LokiMetaSmith/polyvent_control_module/Boards CAD/esp32_main_card/firmware/readme.txt

VentOS runs on this card during normal operation, however scripts in the test_scripts folder can also be used. 

This is the link to the VentOS gitlab repo: https://gitlab.com/project-ventos/ventos
