LokiMetaSmith/polyvent_control_module/Education proportional valve configuration/BOM/Control module parts list.xlsx

Module name in CAD | Multipart assembly name in CAD | Component name in CAD | Description | Quantity | Part number / manufacturing description | Vendor | Notes
Control module |  |  |  |  | Control module wiki link (https://gitlab.com/polyvent/polyvent_control_module/-/wikis/1.0-system-overview)
 |  | guide box | Guide and holds in place the PCB's | 1 | Manufactured out of PLA on a 3D printer
 |  | guide box base | Holds the backp,lane and mounts the guide box to the base frame | 1 | Manufactured out of PLA on a 3D printer
 |  | M3 self-tappping screw 90380A352 | M3*12mm self-tapping screws. These connect the two guide box parts, constrain the cards and hold the backplane | 32 | 90380A352 (https://www.mcmaster.com/90380A352) | McMaster-Carr
 |  | M4*10mm screw 92095A190 | M4*10mm bolts, these bolt the guide box to the faceplate | 6 | 92095A190 (https://www.mcmaster.com/92095A190) | McMaster-Carr
 |  | power plug BVA01-Z0000-01 | Power plug with fuse and switch | 1 | BVA01-Z0000-01 | Digikey | will also need to source a fuse for it
 |  | M3 * 14mm 92095A168 | M3 * 14mm rounded head bolt | 2 | 92095A168 (https://www.mcmaster.com/92095A168) | McMaster-Carr | Generic part
 |  | Not included in CAD | 14AWG wire (black and red) | <1m | Generic | Amazon
 |  | Not included in CAD | 22AWG wire (multicolored) | 5-10m | Generic | Amazon
 |  | Not included in CAD | Not included in CAD | 5 | large spade connector (blue) (https://www.amazon.ca/AIRIC-100pcs-Insulated-Disconnect-Terminal/dp/B06XCWHY1B) | Baomain, on Amazon | These get used up a lot since they're used improperly often. It's good to have way more then you need
 |  | Not included in CAD | Fork connectors (thin wire) | 10 to 20 | small crimp fork (red) (https://www.amazon.ca/Baomain-Insulated-Connector-Electrical-Terminal/dp/B01B1753K2) | Baomain, on Amazon | These get used up a lot since they're used improperly often. It's good to have way more then you need
 |  | Not included in CAD | Fork connectors (thick wire) | 15 to 25 | large crimp fork (blue) (https://www.amazon.ca/gp/product/B01B1DL4OA/ref=ppx_yo_dt_b_search_asin_title?ie=UTF8&psc=1) | Baomain, on Amazon | These get used up a lot since they're used improperly often. It's good to have way more then you need
 |  | Not included in CAD | Crimp ferrules | 1 | Crimp ferrule kit (https://www.amazon.ca/Self-Adjustable-Assortment-Insulated-Electrical-Connectors/dp/B08G4KJ2RR) | Amazon | These get used up a lot since they're used improperly often. It's good to have way more then you need
 | sensing card
 |  | M3 Locknut 90576A102 | M3 locknut | 2 | 90576A102 (https://www.mcmaster.com/90576A102) | McMaster-Carr | Generic part, these should be pre-threaded before insertion, they will destroy your faceplate during threading if you don't do this
 |  | M3*14mm 92095A168 | M3 * 14mm rounded head bolt | 2 | 92095A168 (https://www.mcmaster.com/92095A168) | McMaster-Carr | Generic part
 |  | sensing card face plate |  | 1 | Manufactured out of PLA on a 3D printer
 |  | Sensing card BOM | List of electrical components needed to build the sensing card, it is auto-generated by eagle so it isn't included here | 1 | Many part numbers combined, link to the BOM | Digikey, Mouser
 |  | Sensing card PCB | Sensing card circuit board, can be made by any PCB house | 1 | Link to the design files | JLCPCB
 |  | 15mm brass tube 8859K18 | Thin brass tube, cut to 14mm long | 4 * 14mm: 64mm total | 8859K18 (https://www.mcmaster.com/8859K18) | McMaster-Carr
 | ESP32 card
 |  | M3 Locknut 90576A102 | M3 locknut | 2 | 90576A102 (https://www.mcmaster.com/90576A102) | McMaster-Carr | Generic part, these should be pre-threaded before insertion, they will destroy your faceplate during threading if you don't do this
 |  | M3*14mm 92095A168 | M3 * 14mm rounded head bolt | 2 | 92095A168 (https://www.mcmaster.com/92095A168) | McMaster-Carr | Generic part
 |  | main card face plate |  | 1 | Manufactured out of PLA on a 3D printer
 |  | Main card BOM | List of electrical components needed to build the main card, it is auto-generated by eagle so it isn't included here | 1 | Many part numbers combined, link to the BOM | Digikey, Mouser
 |  | Main card PCB | Main card circuit board, can be made by any PCB house | 1 | Link to the design files | JLCPCB
 | Valves card
 |  | M3 Locknut 90576A102 | M3 locknut | 2 | 90576A102 (https://www.mcmaster.com/90576A102) | McMaster-Carr | Generic part, these should be pre-threaded before insertion, they will destroy your faceplate during threading if you don't do this
 |  | M3*14mm 92095A168 | M3 * 14mm rounded head bolt | 2 | 92095A168 (https://www.mcmaster.com/92095A168) | McMaster-Carr | Generic part
 |  | valves card faceplate |  | 1 | Manufactured out of PLA on a 3D printer
 |  | Valves card BOM | List of electrical components needed to build the valves card, it is auto-generated by eagle so it isn't included here | 1 | Many part numbers combined, link to the BOM | Digikey, Mouser
 |  | Valves card PCB | Valves card circuit board, can be made by any PCB house | 1 | Link to the design files | JLCPCB
 | Backplane V1.2
 |  | Backplane BOM | List of electrical components needed to build the Backplane, it is auto-generated by eagle so it isn't included here | 1 | Many part numbers combined, link to the BOM | Digikey, Mouser
 |  | Backplane PCB | Backplane circuit board, can be made by any PCB house | 1 | Link to the design files | JLCPCB
 | Prototype card (optional)
 |  | M3 Locknut 90576A102 | M3 locknut | 2 | 90576A102 (https://www.mcmaster.com/90576A102) | McMaster-Carr
 |  | M3*14mm 92095A168 | M3 * 14mm rounded head bolt | 2 | 92095A168 (https://www.mcmaster.com/92095A168) | McMaster-Carr
 |  | prototype card faceplate |  | 1 | Custom made by you! (if you choose to build one)
 |  | prototype card BOM |  | 1 | Custom made by you! (if you choose to build one)
 |  | Prototype card PCB | Prototype card circuit board, can be made by any PCB house | 1 | Link to the design files | JLCPCB
 | PSU enclosure
 |  | psu cover 3d printed | Covers the mains wiring and makes everything look neat | 1 | Manufactured out of PLA on a 3d printer, no part number
 |  | PSU cover base plate | Connects the PSU's and psu cover the the base of the machine, acts as a heatsink for the PSU's | 1 | Milled out of aluminum
 |  | LRS-150-24 | 24V power supply | 1 | LRS-150 | Digikey, Mouser, MeanWell
 |  | RS-25-5 | 5V power supply | 1 | RS-25-5 | Digikey, Mouser, MeanWell
 |  | RS-25-3.3 | 3.3V power supply | 1 | RS-25-3.3 | Digikey, Mouser, MeanWell
 |  | M3*6mm 92095A179 | M3 * 6mm bolt | 6 | 92095A179 (https://www.mcmaster.com/92095A179) | McMaster-Carr
