LokiMetaSmith/polyvent_control_module/Boards CAD/blank_card/CAD_model/blank_faceplate_v8.step

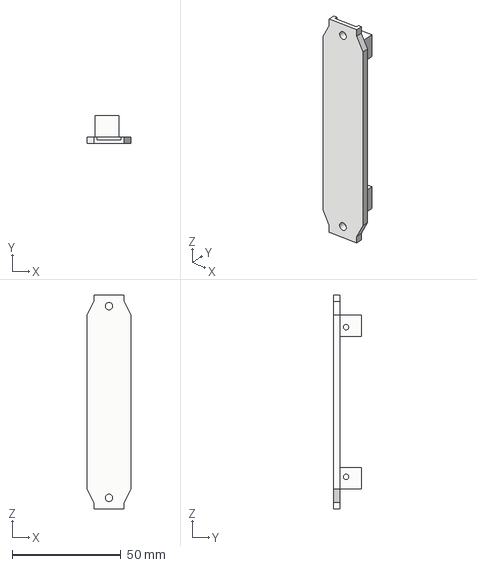
[picture p1: CAD file, 2022-01-12]
Boards CAD/blank_card/CAD_model/blank_faceplate_v8.step
20.2 x 13.0 x 98.3 mm
bent 3d printed body
