LokiMetaSmith/polyvent_control_module/Boards CAD/esp32_main_card/CAD_model/ESP32 card V2.2 v1.step

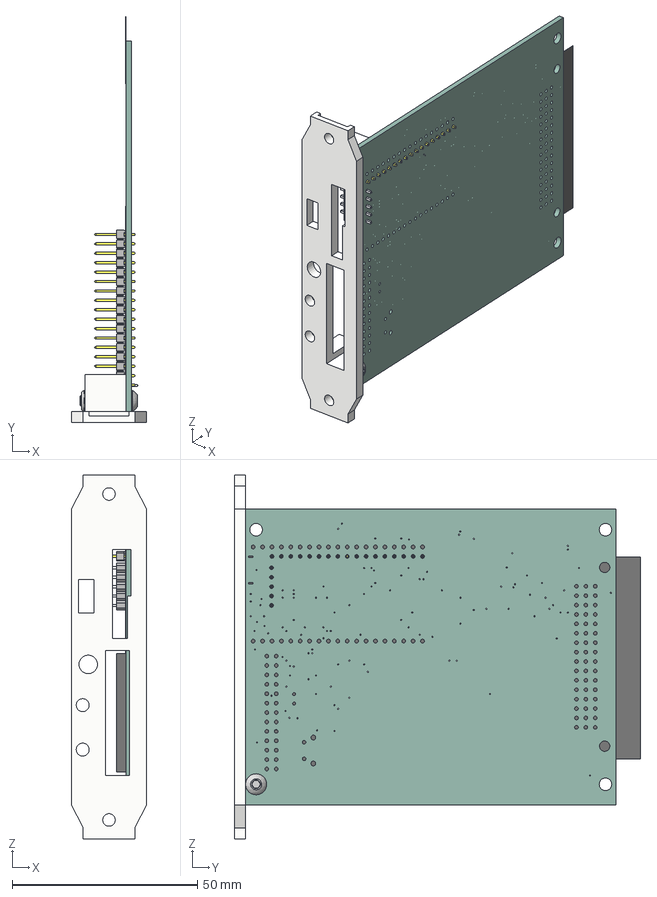
[picture p2: CAD file, 2022-10-12]
Boards CAD/esp32_main_card/CAD_model/ESP32 card V2.2 v1.step
20.2 x 109.6 x 98.3 mm
Board (1)
CL-SB-23A-11T
MODULE_ESP32-DEVKITC-32D
FSMRA4JH04
GCT_USB3090-XX-X_REVE
FE13-2W
HARTING_09231486921 (1)
LED3MM
1X05
_TSW-117-07-G-S_body
_T-1S6-07-TSW-1-07-17-S
valves card face plate (1)
M3*14mm 92095A168
M3 Locknut 90576A102
