LokiMetaSmith/polyvent_control_module/Boards CAD/sensor_card/CAD_model/Sensing card V2.2 v1.step

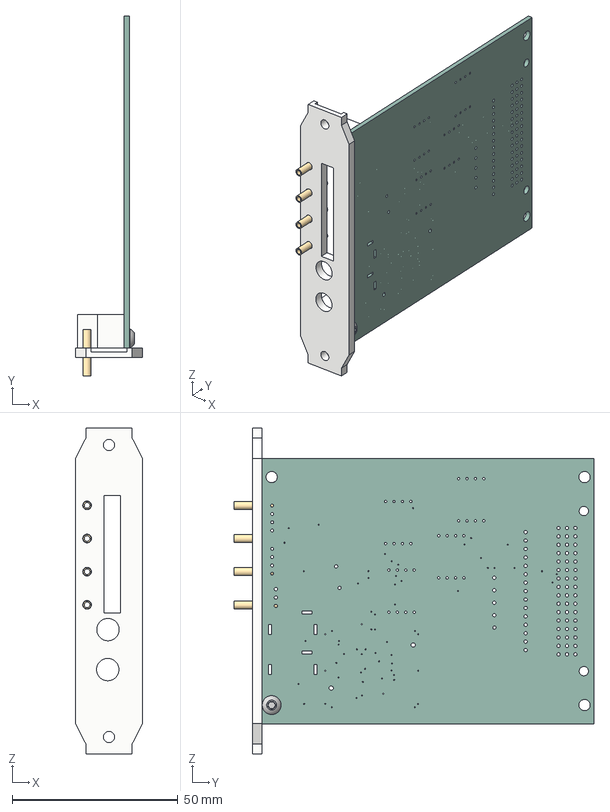
[picture p3: CAD file, 2022-10-12]
Boards CAD/sensor_card/CAD_model/Sensing card V2.2 v1.step
20.2 x 108.5 x 98.3 mm
Board (3)
sensor card faceplate
15mm brass tube 8859K18 x 4
M3*14mm 92095A168
M3 Locknut 90576A102
