LokiMetaSmith/polyvent_control_module/Boards CAD/valves_card/CAD_model/Valves card V2.1 v1.step

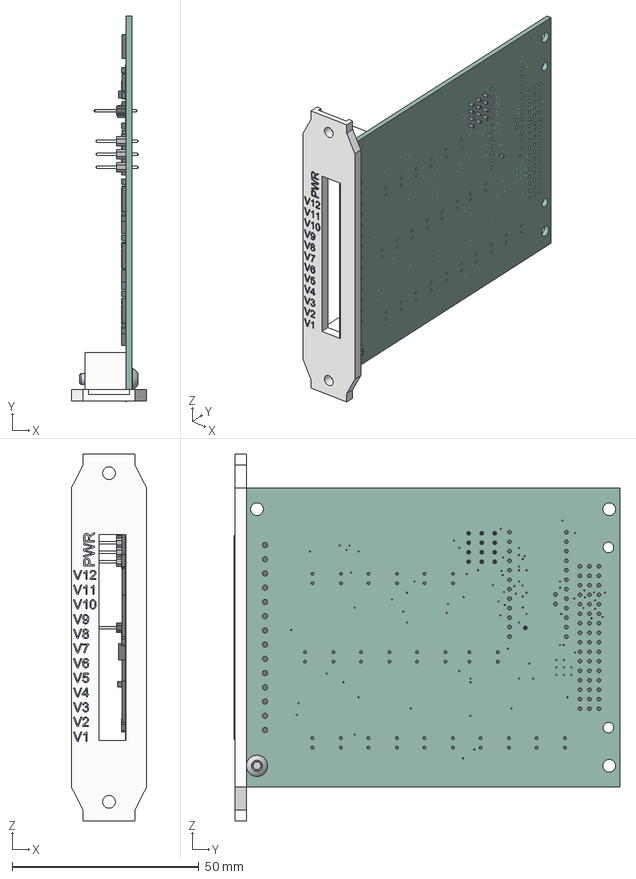
[picture p4: CAD file, 2022-10-12]
Boards CAD/valves_card/CAD_model/Valves card V2.1 v1.step
20.2 x 103.3 x 98.3 mm
Board (2)
DIP762W25P254L650H453Q4B x 12
SOT230P700X180-4N
R0805 x 36
DPAK_TO252 x 12
SJ_2S-NO
SJ_2S-TRACE (1)
JP1_SPARKFUN-SAMD21-MINI-BREAKOUT-V10 (1)
CUI_TBP02R1-381-14BE
HARTING_09231486921 (2)
C0805
C1206
1X01 (1)
1X04 (1) x 3
bent 3d printed body
M3 Locknut 90576A102
M3*14mm 92095A168
