LokiMetaSmith/polyvent_control_module/(list of files, cad)

Other CAD files:
Boards CAD/blank_card/CAD_model/blank_faceplate.f3d
Boards CAD/esp32_main_card/CAD_model/ESP32 card V2.2 v1.f3d
Boards CAD/sensor_card/CAD_model/Sensing card V2.2 v1.f3d
Boards CAD/valves_card/CAD_model/Valves card V2.1 v1.f3d
Education proportional valve configuration/CAD/Education configuration case.f3d
