LokiMetaSmith/polyvent_control_module/Boards CAD/motor_control_card/board/motor control board.brd

## EAGLE design Boards CAD/motor_control_card/board/motor control board.brd (2022-01-12)

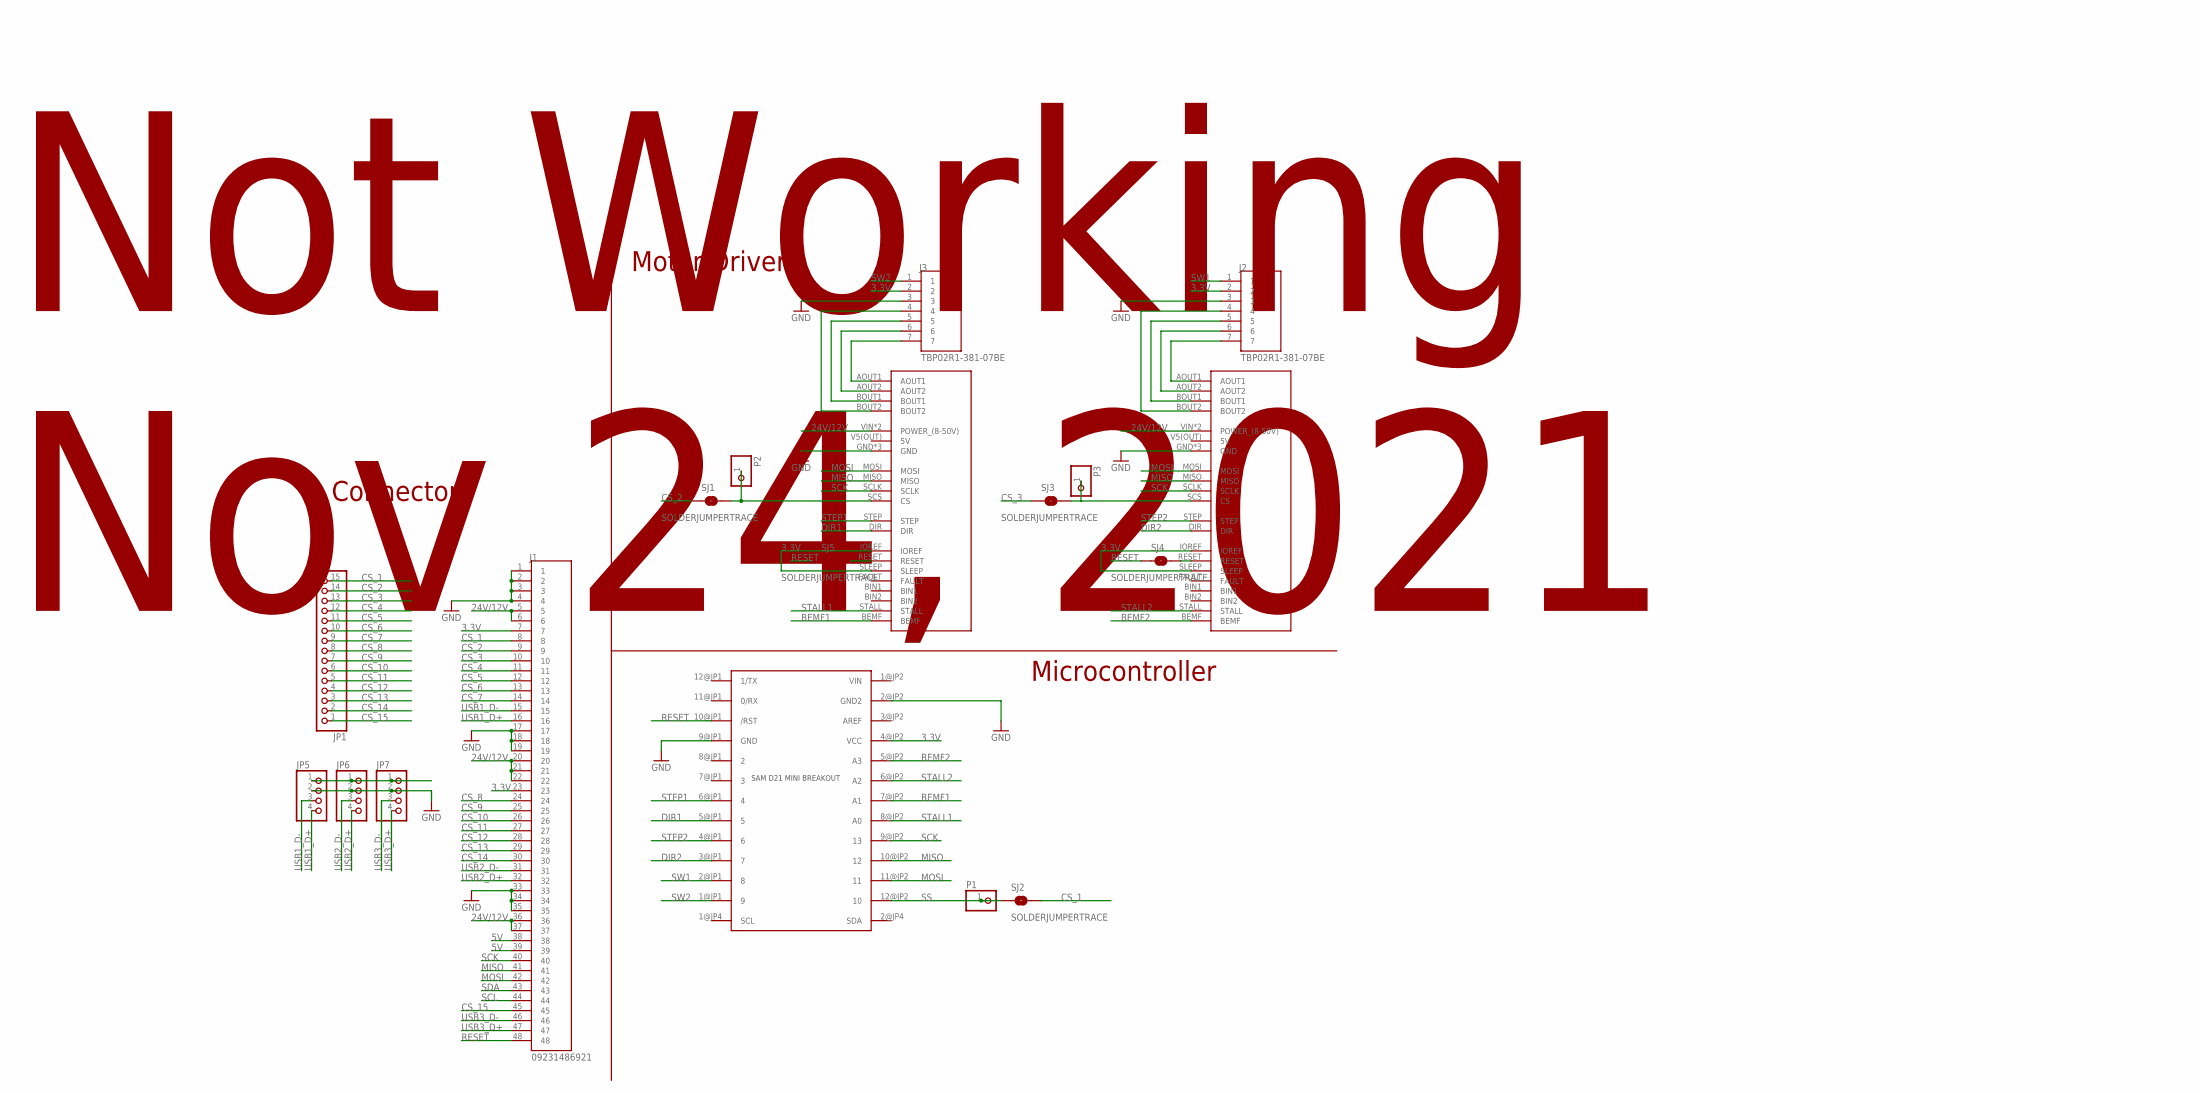
[picture p5: schematic motor control board.sch]

Parts:
J1: 09231486921; HARTING_09231486921
J2, J3: TBP02R1-381-07BE; CUI_TBP02R1-381-07BE
JP1: PINHD-1X15; 1X15
JP5, JP6, JP7: PINHD-1X4; 1X04
P1, P2, P3: PINHD-1X1; 1X01
SJ1, SJ2, SJ3, SJ4, SJ5: SOLDERJUMPERTRACE; SJ_2S-TRACE
U$1, U$2: POLOLU_HIGH-POWER_STEPPER_MOTOR_DRIVER_36V4; BREAKOUT_BOARD
U$4: SAM_D21_MINI_BREAKOUT; JP1_SPARKFUN-SAMD21-MINI-BREAKOUT-V10

Connections:
3.3V: J1.7, J1.23, J2.2, J3.2, U$1.IOREF, U$1.SLEEP, U$2.IOREF, U$2.SLEEP, U$4.4@JP2 (VCC)
5V: J1.38, J1.39, JP5.1, JP6.1, JP7.1
24V/12V: J1.5, J1.6, J1.20, J1.21, J1.22, J1.36, J1.37, U$1.VIN (POWER_(8-50V)), U$1.VIN_2 (POWER_(8-50V)), U$2.VIN (POWER_(8-50V)), U$2.VIN_2 (POWER_(8-50V))
AREF: U$4.3@JP2 (AREF)
BEMF1: U$1.BEMF, U$4.7@JP2 (A1)
BEMF2: U$2.BEMF, U$4.5@JP2 (A3)
CS_1: J1.8, JP1.15, SJ2.2
CS_2: J1.9, JP1.14, SJ1.1
CS_3: J1.10, JP1.13, SJ3.1
CS_4: J1.11, JP1.12
CS_5: J1.12, JP1.11
CS_6: J1.13, JP1.10
CS_7: J1.14, JP1.9
CS_8: J1.24, JP1.8
CS_9: J1.25, JP1.7
CS_10: J1.26, JP1.6
CS_11: J1.27, JP1.5
CS_12: J1.28, JP1.4
CS_13: J1.29, JP1.3
CS_14: J1.30, JP1.2
CS_15: J1.45, JP1.1
DIR1: U$1.DIR, U$4.5@JP1 (5)
DIR2: U$2.DIR, U$4.3@JP1 (7)
GND: J1.1, J1.2, J1.3, J1.4, J1.17, J1.18, J1.19, J1.33, J1.34, J1.35, J2.3, J3.3, JP5.2, JP6.2, JP7.2, U$1.GND, U$1.GND_2 (GND), U$1.GND_3 (GND), U$2.GND, U$2.GND_2 (GND), U$2.GND_3 (GND), U$4.9@JP1 (GND)
MISO: J1.41, U$1.MISO, U$2.MISO, U$4.10@JP2 (12)
MOSI: J1.42, U$1.MOSI, U$2.MOSI, U$4.11@JP2 (11)
unnamed: J3.7, U$1.AOUT1
unnamed: J3.6, U$1.AOUT2
unnamed: J3.5, U$1.BOUT1
unnamed: J3.4, U$1.BOUT2
unnamed: SJ4.2, U$2.RESET
unnamed: J2.7, U$2.AOUT1
unnamed: J2.6, U$2.AOUT2
unnamed: J2.5, U$2.BOUT1
unnamed: J2.4, U$2.BOUT2
unnamed: P2.1, SJ1.2, U$1.SCS (CS)
unnamed: SJ5.2, U$1.RESET
unnamed: P3.1, SJ3.2, U$2.SCS (CS)
RESET: J1.48, SJ4.1, SJ5.1, U$4.10@JP1 (/RST)
SCK: J1.40, U$1.SCLK, U$2.SCLK, U$4.9@JP2 (13)
SCL: J1.44
SDA: J1.43
SS: P1.1, SJ2.1, U$4.12@JP2 (10)
STALL1: U$1.STALL, U$4.8@JP2 (A0)
STALL2: U$2.STALL, U$4.6@JP2 (A2)
STEP1: U$1.STEP, U$4.6@JP1 (4)
STEP2: U$2.STEP, U$4.4@JP1 (6)
SW1: J2.1, U$4.2@JP1 (8)
SW2: J3.1, U$4.1@JP1 (9)
USB1_D+: J1.16, JP5.4
USB1_D-: J1.15, JP5.3
USB2_D+: J1.32, JP6.4
USB2_D-: J1.31, JP6.3
USB3_D+: J1.47, JP7.4
USB3_D-: J1.46, JP7.3
VIN: U$4.1@JP2 (VIN)

Notes on the sheet:
Microcontroller
Motor Drivers
Connectors
Not Working Nov 24, 2021

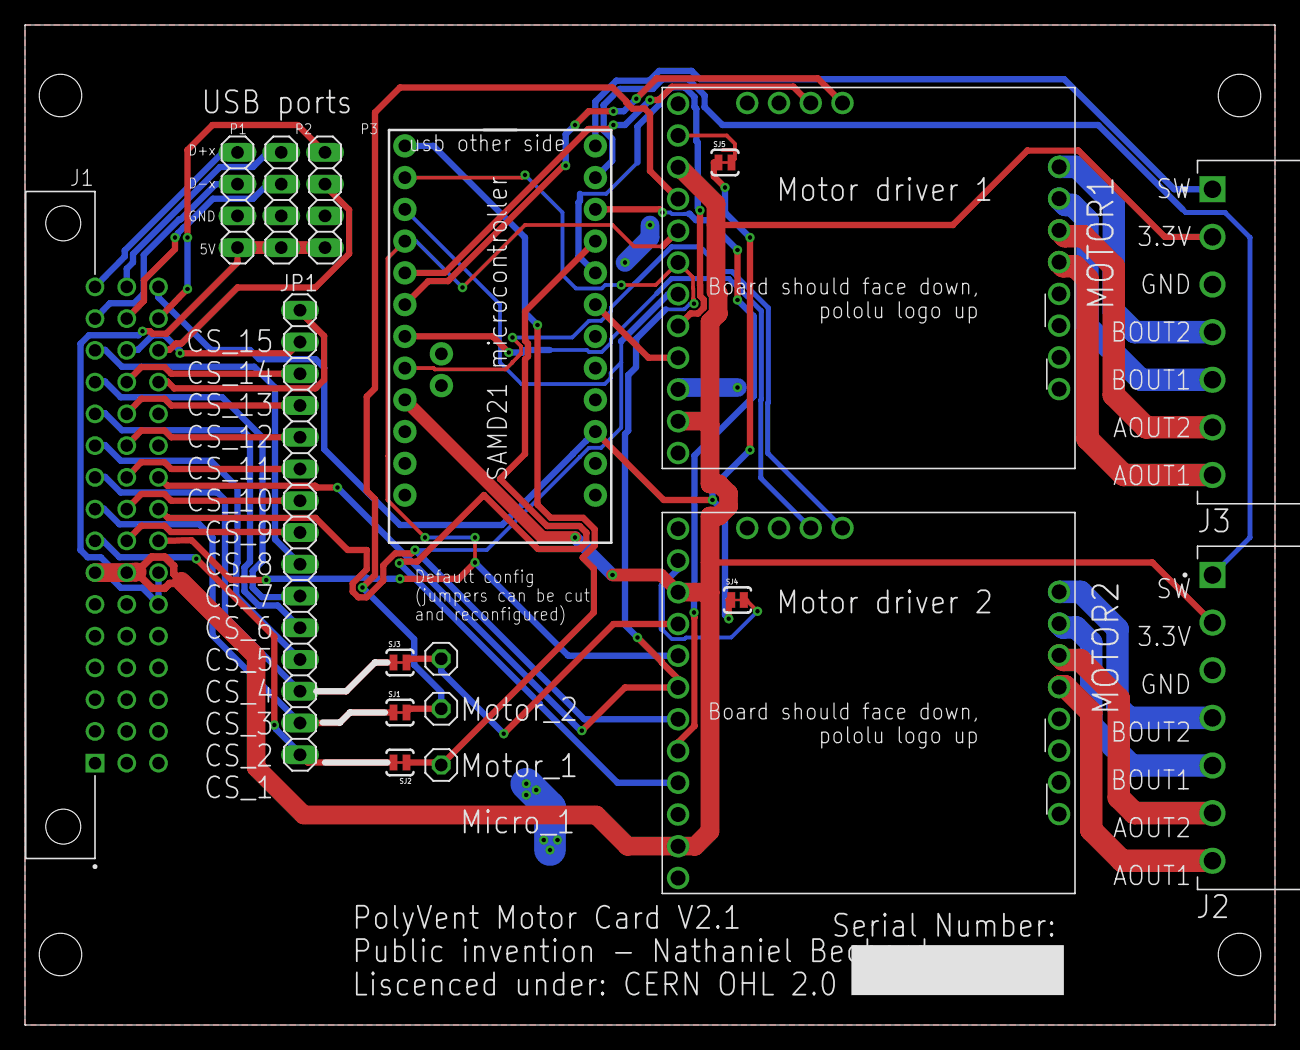
[picture p6: board motor control board.brd from above]

Board: 2 copper layers, 100.0 x 80.0 mm, 18 parts (0 on the bottom side), 52 nets.
