LokiMetaSmith/polyvent_control_module/Boards CAD/esp32_main_card/board/esp32_main_card.brd

## EAGLE design Boards CAD/esp32_main_card/board/esp32_main_card.brd (2022-01-12)

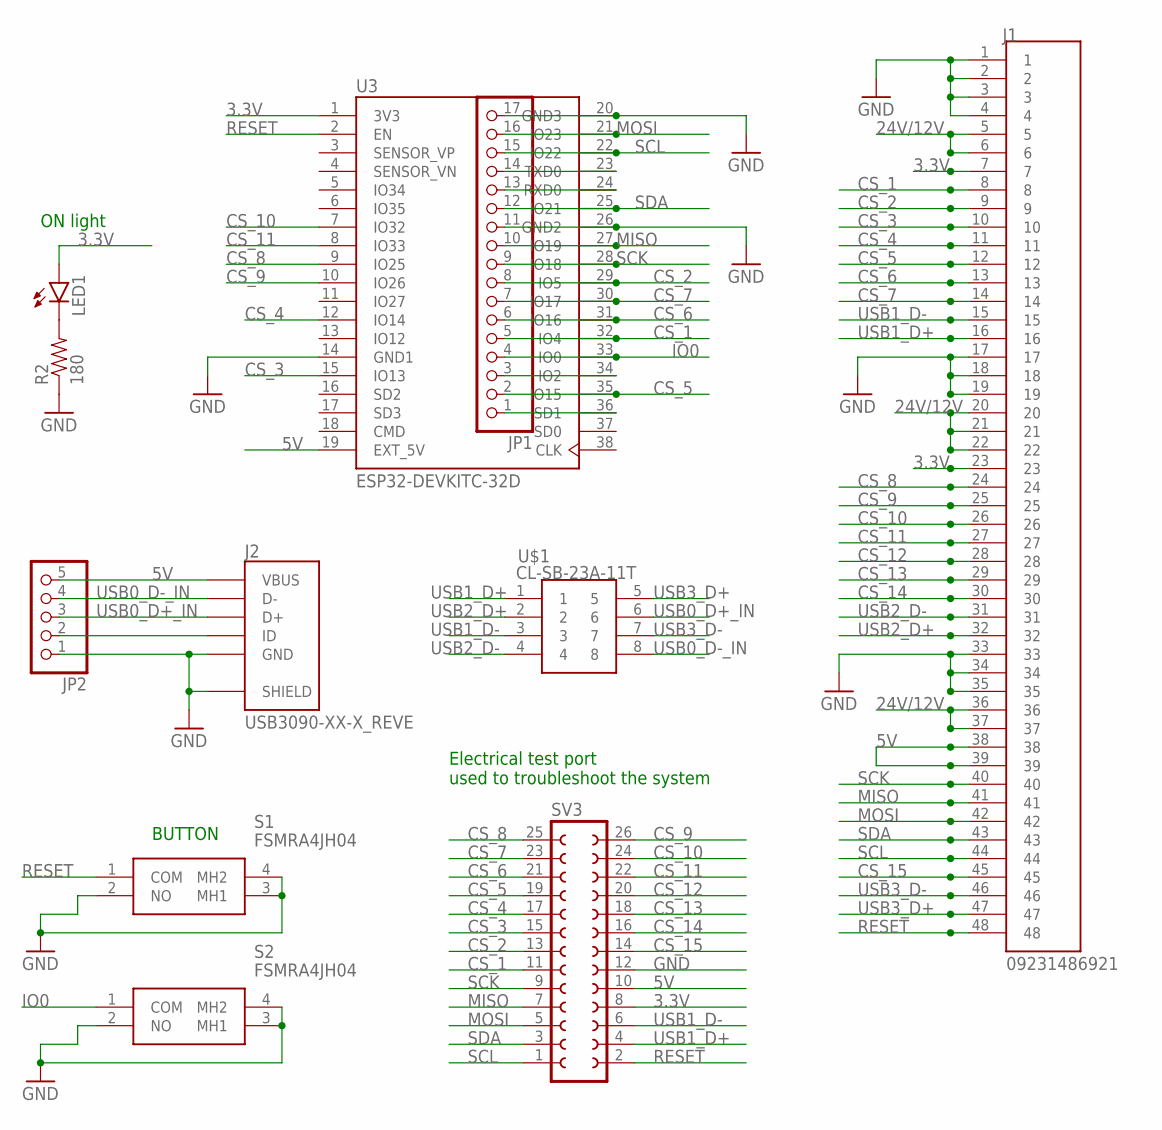
[picture p9: schematic esp32_main_card.sch]

Parts:
J1: 09231486921; HARTING_09231486921
J2: USB3090-XX-X_REVE; GCT_USB3090-XX-X_REVE
JP1: PINHD-1X17; 1X17
JP2: PINHD-1X5; 1X05
LED1: LED3MM
R2: 180; 0805
S1, S2: FSMRA4JH04
SV3: FE13-2W
U3: ESP32-DEVKITC-32D; MODULE_ESP32-DEVKITC-32D
U$1: CL-SB-23A-11T

Connections:
3.3V: J1.7, J1.23, LED1.A, SV3.8, U3.1 (3V3)
5V: J1.38, J1.39, J2.1 (VBUS), JP2.5, SV3.10, U3.19 (EXT_5V)
24V/12V: J1.5, J1.6, J1.20, J1.21, J1.22, J1.36, J1.37
CS_1: J1.8, JP1.5, SV3.11, U3.32 (IO4)
CS_2: J1.9, JP1.8, SV3.13, U3.29 (IO5)
CS_3: J1.10, SV3.15, U3.15 (IO13)
CS_4: J1.11, SV3.17, U3.12 (IO14)
CS_5: J1.12, JP1.2, SV3.19, U3.35 (IO15)
CS_6: J1.13, JP1.6, SV3.21, U3.31 (IO16)
CS_7: J1.14, JP1.7, SV3.23, U3.30 (IO17)
CS_8: J1.24, SV3.25, U3.9 (IO25)
CS_9: J1.25, SV3.26, U3.10 (IO26)
CS_10: J1.26, SV3.24, U3.7 (IO32)
CS_11: J1.27, SV3.22, U3.8 (IO33)
CS_12: J1.28, SV3.20
CS_13: J1.29, SV3.18
CS_14: J1.30, SV3.16
CS_15: J1.45, SV3.14
GND: J1.1, J1.2, J1.3, J1.4, J1.17, J1.18, J1.19, J1.33, J1.34, J1.35, J2.5 (GND), J2.6 (SHIELD), J2.7 (SHIELD), J2.8 (SHIELD), J2.9 (SHIELD), JP1.11, JP2.1, R2.1, S1.2 (NO), S1.3 (MH1), S1.4 (MH2), S2.2 (NO), S2.3 (MH1), S2.4 (MH2), SV3.12, U3.14 (GND1), U3.26 (GND2)
IO0: JP1.4, S2.1 (COM), U3.33 (IO0)
MISO: J1.41, JP1.10, SV3.7, U3.27 (IO19)
MOSI: J1.42, JP1.16, SV3.5, U3.21 (IO23)
unnamed: J2.4 (ID), JP2.2
unnamed: JP1.17, U3.20 (GND3)
unnamed: JP1.14, U3.23 (TXD0)
unnamed: JP1.13, U3.24 (RXD0)
unnamed: JP1.3, U3.34 (IO2)
unnamed: JP1.1, U3.36 (SD1)
unnamed: LED1.K (C), R2.2
RESET: J1.48, S1.1 (COM), SV3.2, U3.2 (EN)
SCK: J1.40, JP1.9, SV3.9, U3.28 (IO18)
SCL: J1.44, JP1.15, SV3.1, U3.22 (IO22)
SDA: J1.43, JP1.12, SV3.3, U3.25 (IO21)
USB0_D+_IN: J2.3 (D+), JP2.3, U$1.6
USB0_D-_IN: J2.2 (D-), JP2.4, U$1.8
USB1_D+: J1.16, SV3.4, U$1.1
USB1_D-: J1.15, SV3.6, U$1.3
USB2_D+: J1.32, U$1.2
USB2_D-: J1.31, U$1.4
USB3_D+: J1.47, U$1.5
USB3_D-: J1.46, U$1.7

Notes on the sheet:
Electrical test port used to troubleshoot the system
BUTTON
ON light

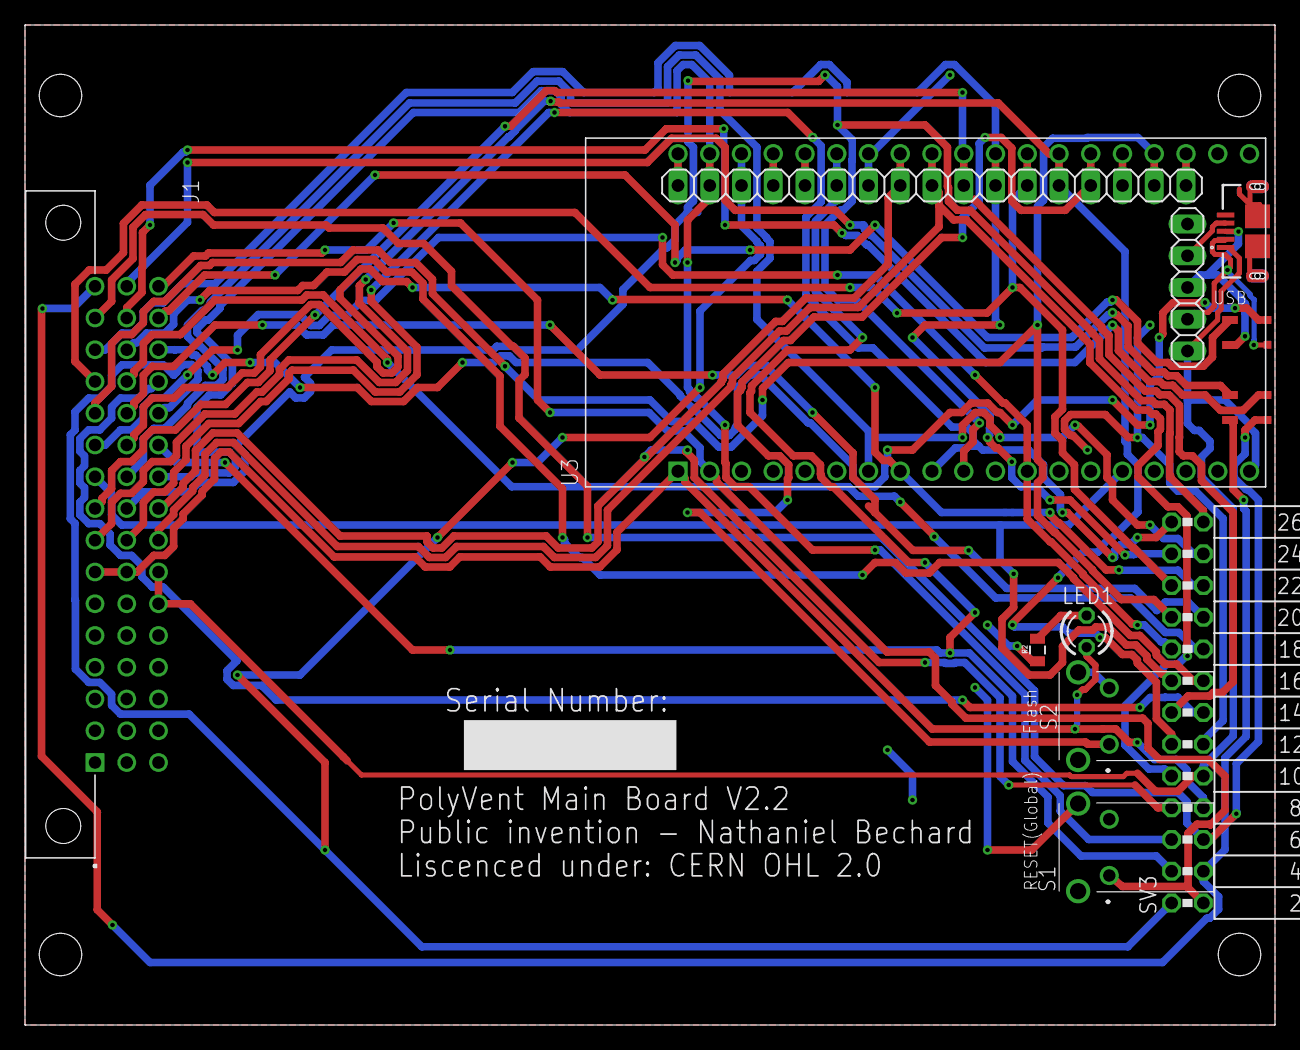
[picture p10: board esp32_main_card.brd from above]

Board: 2 copper layers, 100.0 x 80.0 mm, 11 parts (0 on the bottom side), 41 nets.
