LokiMetaSmith/polyvent_control_module/Boards CAD/valves_card/board/valves card.brd

## EAGLE design Boards CAD/valves_card/board/valves card.brd (2021-11-24)

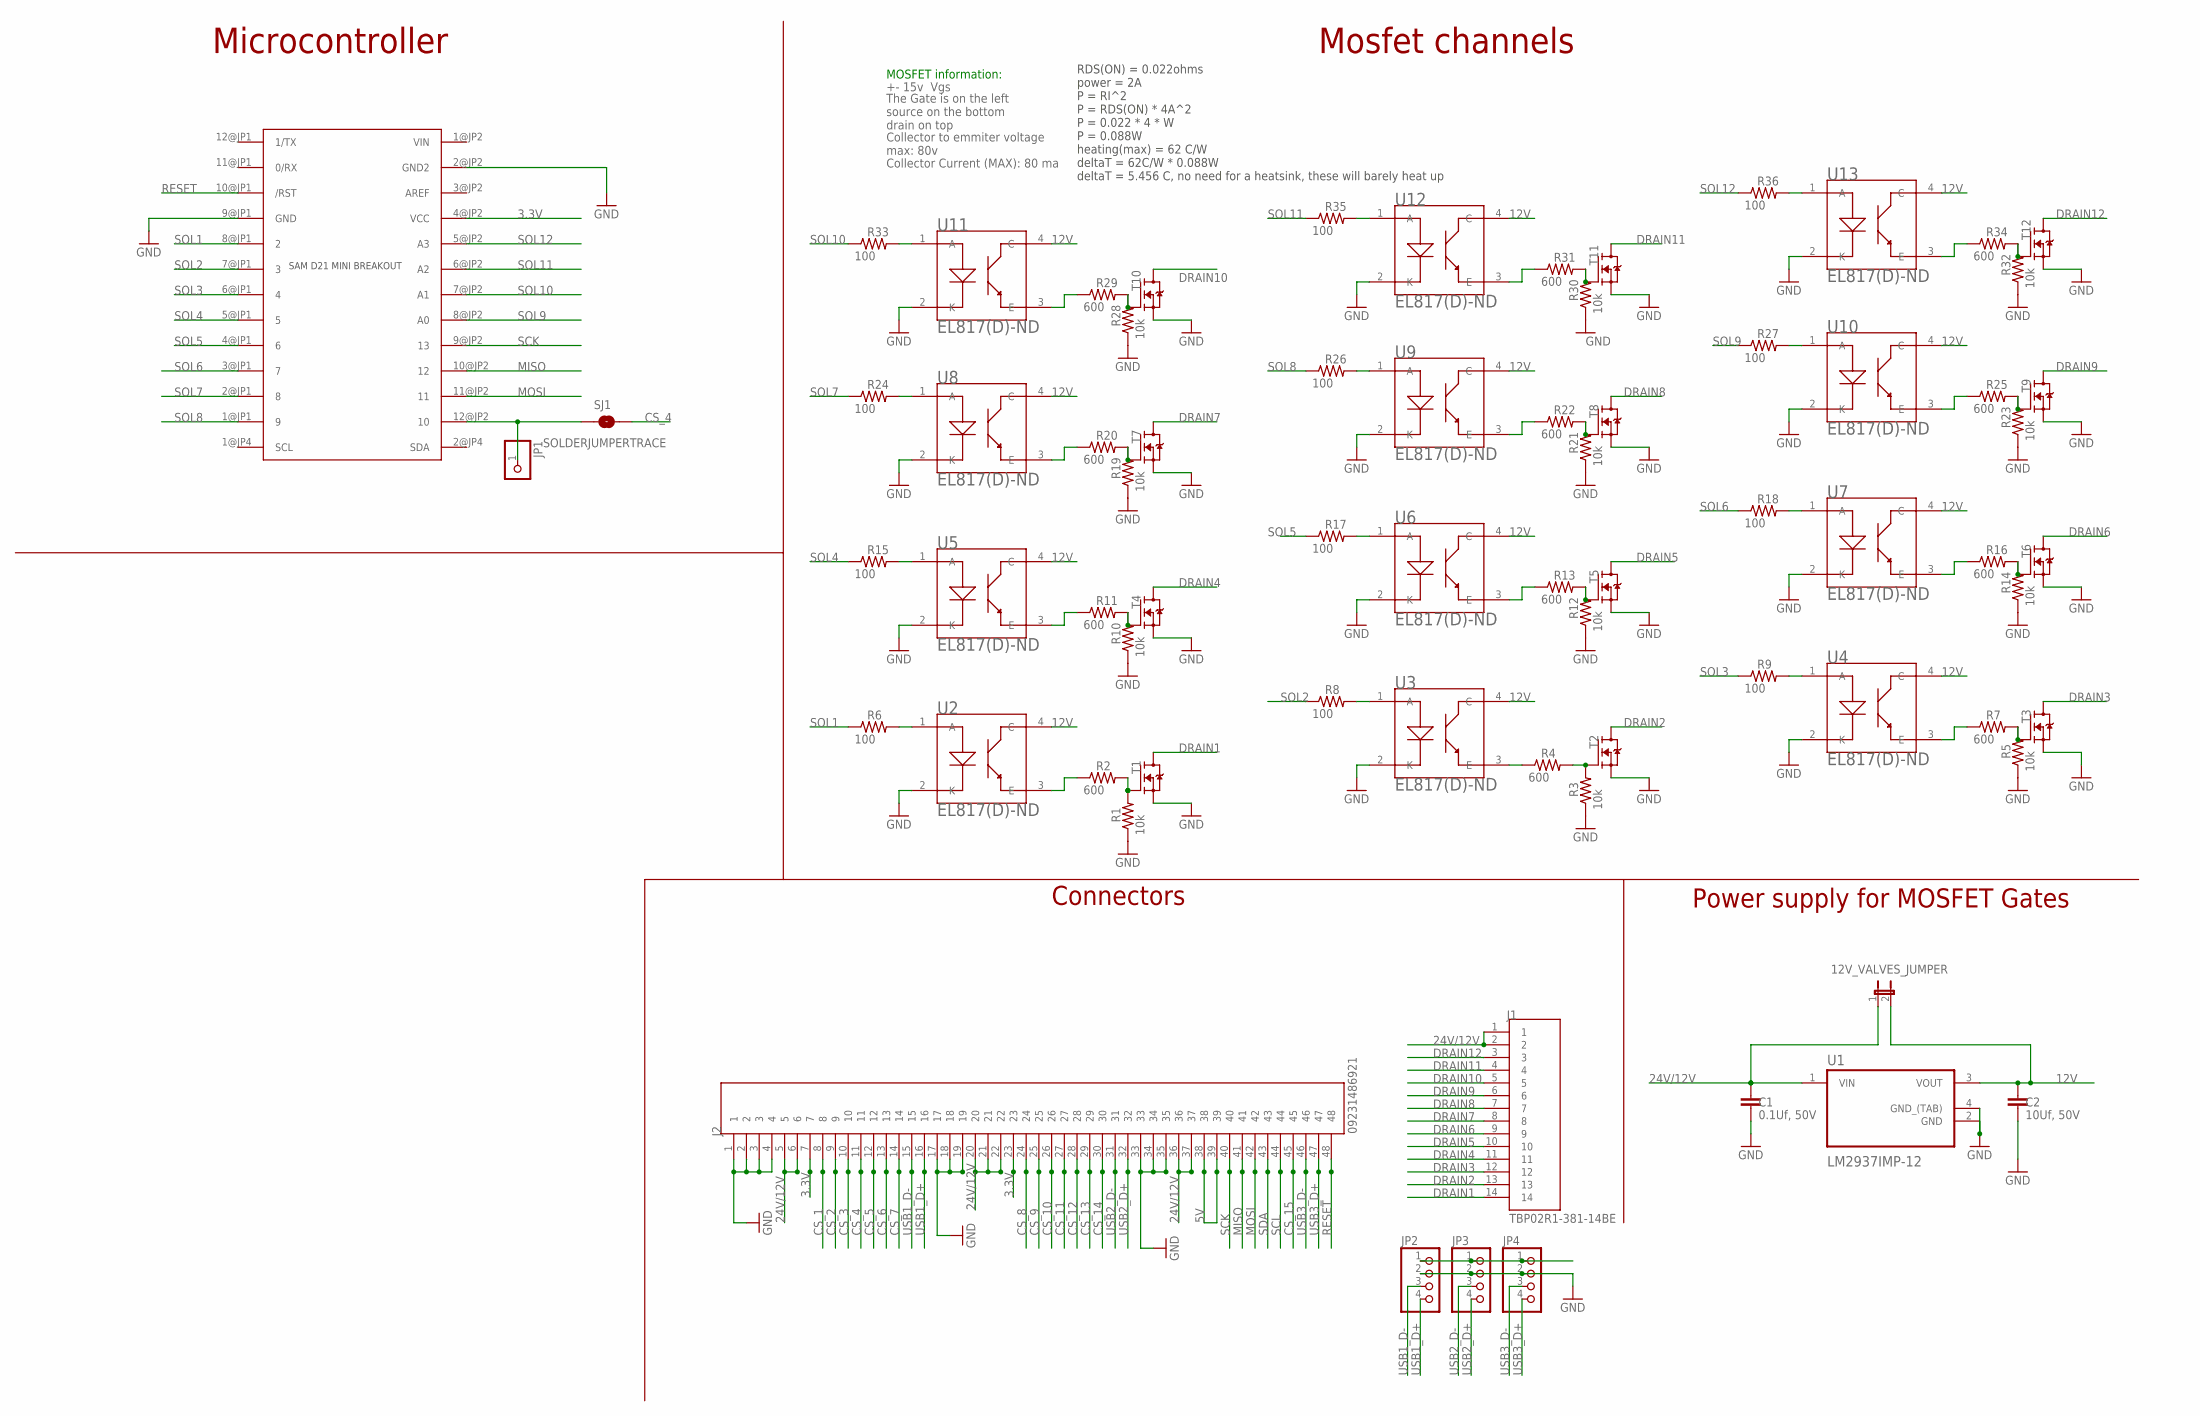
[picture p13: schematic valves card.sch]

Parts:
12V_VALVES_JUMPER: JUMPER-2SMD-NO; SJ_2S-NO
C1: 0.1Uf, 50V; 0805
C2: 10Uf, 50V; 0805
J1: TBP02R1-381-14BE; CUI_TBP02R1-381-14BE
J2: 09231486921; HARTING_09231486921
JP1: PINHD-1X1; 1X01
JP2, JP3, JP4: PINHD-1X4; 1X04
M2: SAM_D21_MINI_BREAKOUT; JP1_SPARKFUN-SAMD21-MINI-BREAKOUT-V10
R1, R3, R5, R10, R12, R14, R19, R21, R23, R28, R30, R32: 10k; 0805
R2, R4, R7, R11, R13, R16, R20, R22, R25, R29, R31, R34: 600; 0805
R6, R8, R9, R15, R17, R18, R24, R26, R27, R33, R35, R36: 100; 0805
SJ1: SOLDERJUMPERTRACE; SJ_2S-TRACE
T1, T2, T3, T4, T5, T6, T7, T8, T9, T10, T11, T12: IRLZ44NSTRLPBF; DPAK_TO252
U1: LM2937IMP-12; SOT230P700X180-4N
U2, U3, U4, U5, U6, U7, U8, U9, U10, U11, U12, U13: EL817(D)-ND; DIP4

Connections:
3.3V: J2.7, J2.23, M2.4@JP2 (VCC)
5V: J2.38, J2.39, JP2.1, JP3.1, JP4.1
12V: 12V_VALVES_JUMPER.2, C2.1, U1.3 (VOUT), U2.4 (C), U3.4 (C), U4.4 (C), U5.4 (C), U6.4 (C), U7.4 (C), U8.4 (C), U9.4 (C), U10.4 (C), U11.4 (C), U12.4 (C), U13.4 (C)
24V/12V: 12V_VALVES_JUMPER.1, C1.1, J1.1, J1.2, J2.5, J2.6, J2.20, J2.21, J2.22, J2.36, J2.37, U1.1 (VIN)
AREF: M2.3@JP2 (AREF)
CS_1: J2.8
CS_2: J2.9
CS_3: J2.10
CS_4: J2.11, SJ1.2
CS_5: J2.12
CS_6: J2.13
CS_7: J2.14
CS_8: J2.24
CS_9: J2.25
CS_10: J2.26
CS_11: J2.27
CS_12: J2.28
CS_13: J2.29
CS_14: J2.30
CS_15: J2.45
DRAIN1: J1.14, T1.2 (D)
DRAIN2: J1.13, T2.2 (D)
DRAIN3: J1.12, T3.2 (D)
DRAIN4: J1.11, T4.2 (D)
DRAIN5: J1.10, T5.2 (D)
DRAIN6: J1.9, T6.2 (D)
DRAIN7: J1.8, T7.2 (D)
DRAIN8: J1.7, T8.2 (D)
DRAIN9: J1.6, T9.2 (D)
DRAIN10: J1.5, T10.2 (D)
DRAIN11: J1.4, T11.2 (D)
DRAIN12: J1.3, T12.2 (D)
GND: C1.2, C2.2, J2.1, J2.2, J2.3, J2.4, J2.17, J2.18, J2.19, J2.33, J2.34, J2.35, JP2.2, JP3.2, JP4.2, M2.2@JP2 (GND2), M2.9@JP1 (GND), R1.1, R3.1, R5.1, R10.1, R12.1, R14.1, R19.1, R21.1, R23.1, R28.1, R30.1, R32.1, T1.3 (S), T2.3 (S), T3.3 (S), T4.3 (S), T5.3 (S), T6.3 (S), T7.3 (S), T8.3 (S), T9.3 (S), T10.3 (S), T11.3 (S), T12.3 (S), U1.2 (GND), U1.4 (GND_(TAB)), U2.2 (K), U3.2 (K), U4.2 (K), U5.2 (K), U6.2 (K), U7.2 (K), U8.2 (K), U9.2 (K), U10.2 (K), U11.2 (K), U12.2 (K), U13.2 (K)
MISO: J2.41, M2.10@JP2 (12)
MOSI: J2.42, M2.11@JP2 (11)
unnamed: JP1.1, M2.12@JP2 (10), SJ1.1
unnamed: R6.2, U2.1 (A)
unnamed: R1.2, R2.2, T1.1 (G)
unnamed: R2.1, U2.3 (E)
unnamed: R3.2, R4.2, T2.1 (G)
unnamed: R4.1, U3.3 (E)
unnamed: R8.2, U3.1 (A)
unnamed: R5.2, R7.2, T3.1 (G)
unnamed: R7.1, U4.3 (E)
unnamed: R9.2, U4.1 (A)
unnamed: R10.2, R11.2, T4.1 (G)
unnamed: R11.1, U5.3 (E)
unnamed: R15.2, U5.1 (A)
unnamed: R12.2, R13.2, T5.1 (G)
unnamed: R13.1, U6.3 (E)
unnamed: R17.2, U6.1 (A)
unnamed: R14.2, R16.2, T6.1 (G)
unnamed: R16.1, U7.3 (E)
unnamed: R18.2, U7.1 (A)
unnamed: R19.2, R20.2, T7.1 (G)
unnamed: R20.1, U8.3 (E)
unnamed: R24.2, U8.1 (A)
unnamed: R21.2, R22.2, T8.1 (G)
unnamed: R22.1, U9.3 (E)
unnamed: R26.2, U9.1 (A)
unnamed: R23.2, R25.2, T9.1 (G)
unnamed: R25.1, U10.3 (E)
unnamed: R27.2, U10.1 (A)
unnamed: R28.2, R29.2, T10.1 (G)
unnamed: R29.1, U11.3 (E)
unnamed: R33.2, U11.1 (A)
unnamed: R30.2, R31.2, T11.1 (G)
unnamed: R31.1, U12.3 (E)
unnamed: R35.2, U12.1 (A)
unnamed: R32.2, R34.2, T12.1 (G)
unnamed: R34.1, U13.3 (E)
unnamed: R36.2, U13.1 (A)
RESET: J2.48, M2.10@JP1 (/RST)
SCK: J2.40, M2.9@JP2 (13)
SCL: J2.44
SDA: J2.43
SOL1: M2.8@JP1 (2), R6.1
SOL2: M2.7@JP1 (3), R8.1
SOL3: M2.6@JP1 (4), R9.1
SOL4: M2.5@JP1 (5), R15.1
SOL5: M2.4@JP1 (6), R17.1
SOL6: M2.3@JP1 (7), R18.1
SOL7: M2.2@JP1 (8), R24.1
SOL8: M2.1@JP1 (9), R26.1
SOL9: M2.8@JP2 (A0), R27.1
SOL10: M2.7@JP2 (A1), R33.1
SOL11: M2.6@JP2 (A2), R35.1
SOL12: M2.5@JP2 (A3), R36.1
USB1_D+: J2.16, JP2.4
USB1_D-: J2.15, JP2.3
USB2_D+: J2.32, JP3.4
USB2_D-: J2.31, JP3.3
USB3_D+: J2.47, JP4.4
USB3_D-: J2.46, JP4.3
VIN: M2.1@JP2 (VIN)

Notes on the sheet:
The Gate is on the left source on the bottom drain on top
+- 15v Vgs
Collector to emmiter voltage max: 80v
Collector Current (MAX): 80 ma
MOSFET information:
RDS(ON) = 0.022ohms power = 2A P = RI^2 P = RDS(ON) * 4A^2 P = 0.022 * 4 * W P = 0.088W heating(max) = 62 C/W deltaT = 62C/W * 0.088W deltaT = 5.456 C, no need for a heatsink, these will barely heat up
Mosfet channels
Power supply for MOSFET Gates
Microcontroller
Connectors
