LokiMetaSmith/polyvent_control_module/Boards CAD/valves_card/board/valves card.brd

## EAGLE design Boards CAD/valves_card/board/valves card.brd (continued)

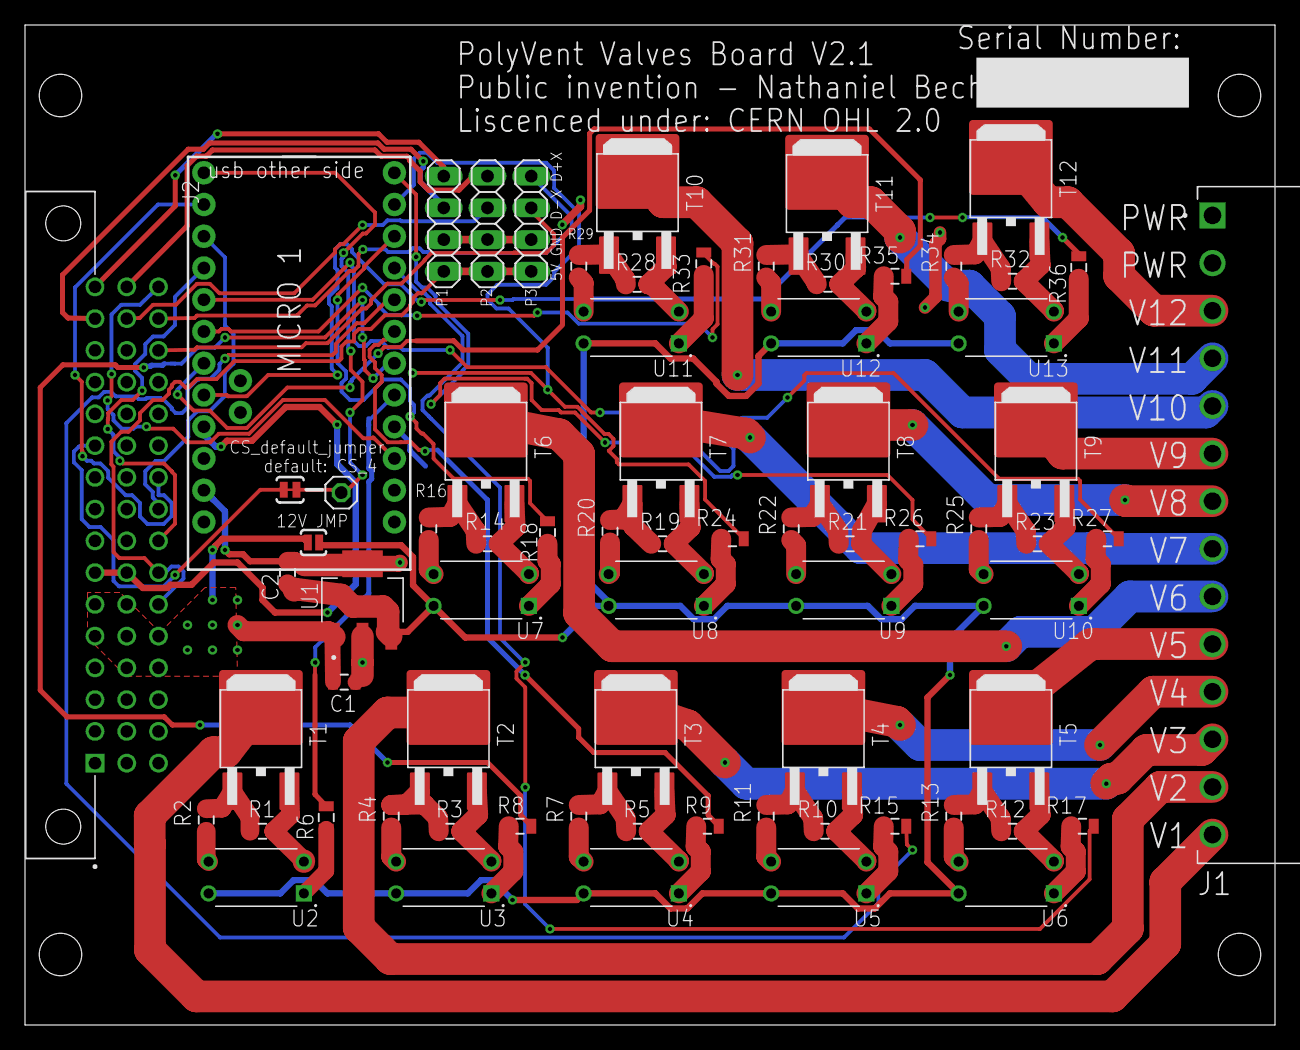
[picture p14: board valves card.brd from above]

Board: 2 copper layers, 100.0 x 80.0 mm, 72 parts (0 on the bottom side), 77 nets.
