LokiMetaSmith/polyvent_control_module/Boards CAD/sensor_card/board/sensor card.brd

## EAGLE design Boards CAD/sensor_card/board/sensor card.brd (2022-07-15)

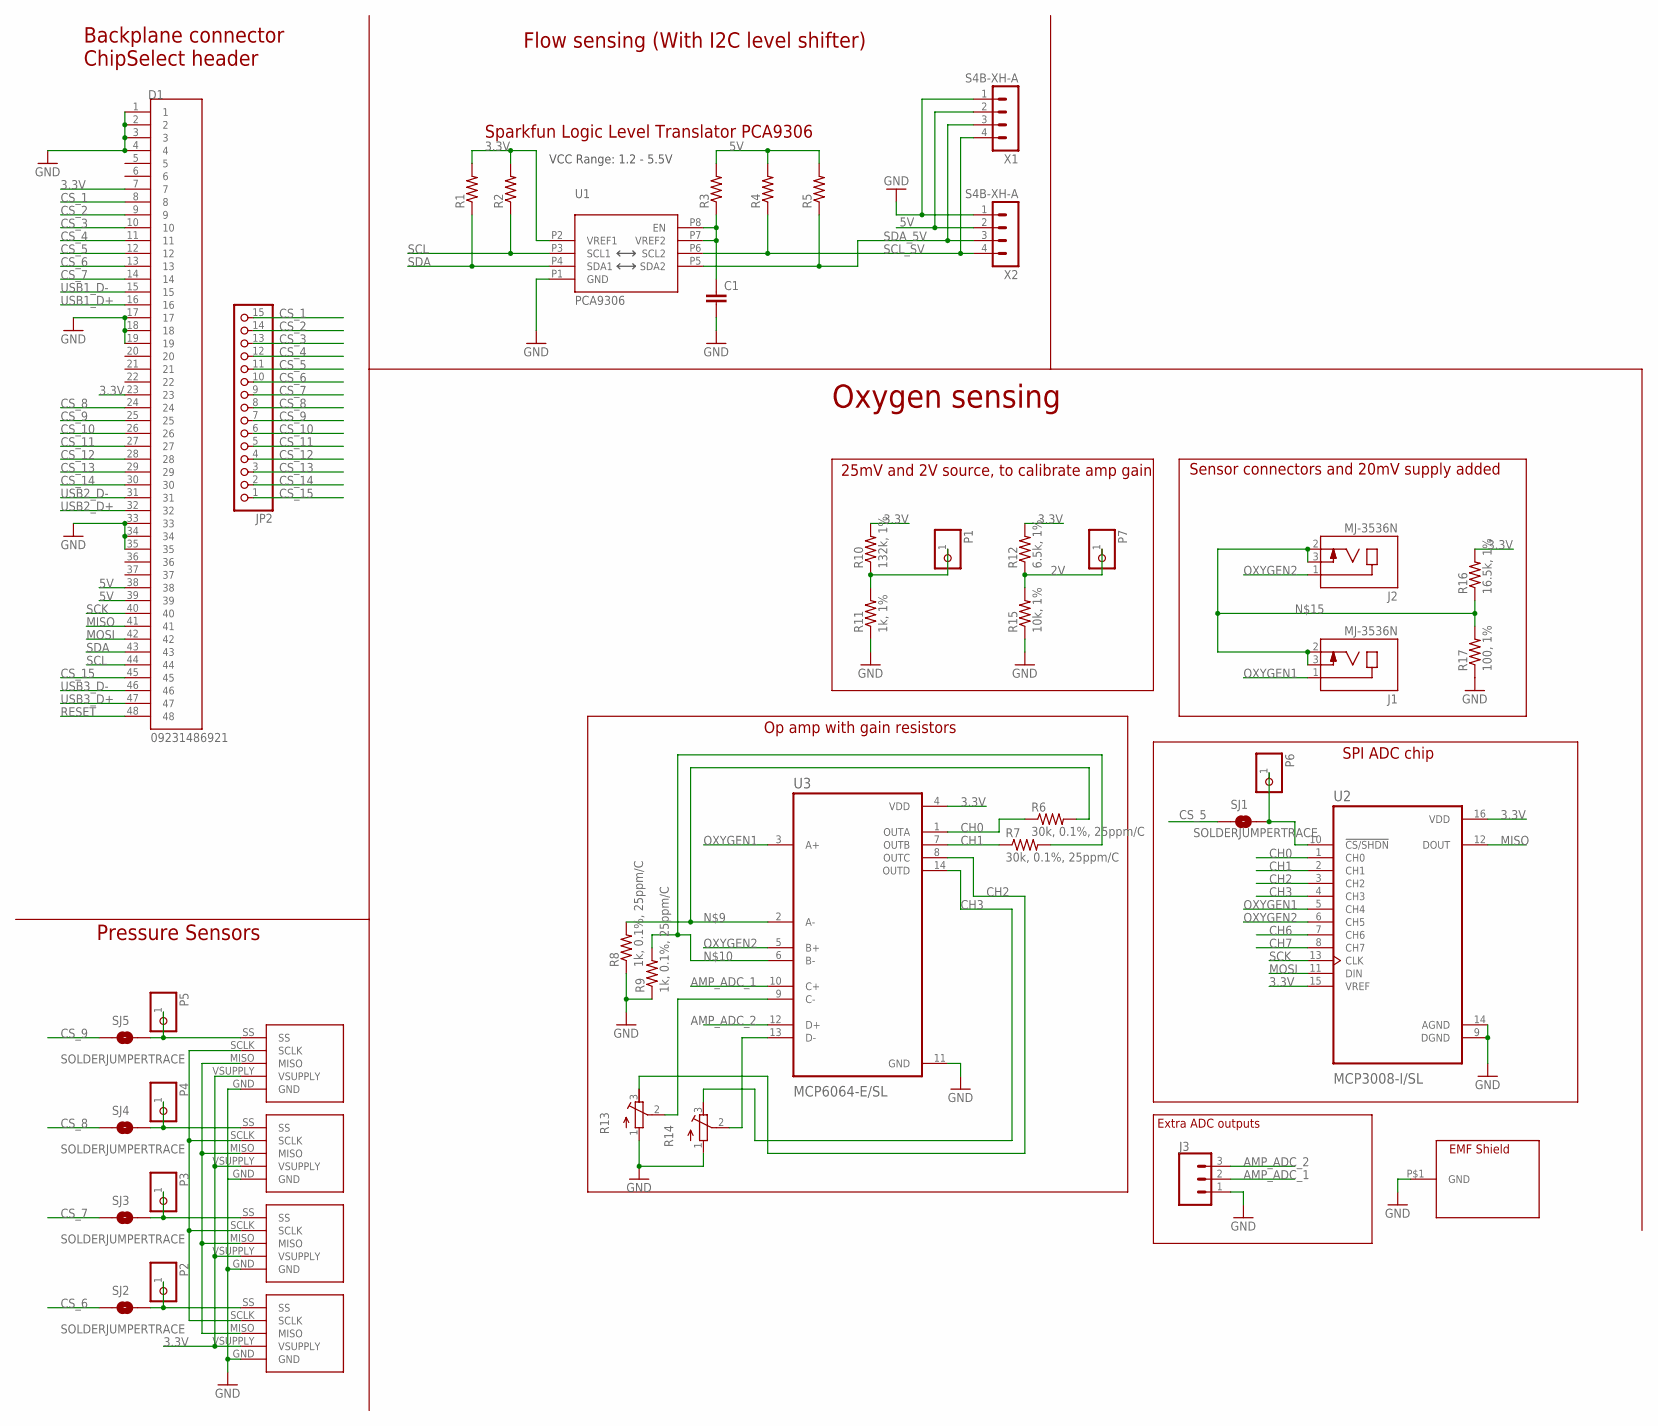
[picture p15: schematic sensor card.sch]

Parts:
C1: 100pF; 0805
D1: 09231486921; HARTING_09231486921
J1, J2: MJ-3536N; CUI_MJ-3536N
J3: CONN_03; 1X03
JP2: PINHD-1X15; 1X15
P1, P2, P3, P4, P5, P6, P7: PINHD-1X1; 1X01
R1, R2, R4, R5: 2.2k; 0805
R3: 200K; 0805
R6, R7: 30k, 0.1%, 25ppm/C; 0805
R8, R9: 1k, 0.1%, 25ppm/C; 0805
R10: 132k, 1%; 0805
R11: 1k, 1%; 0805
R12: 6.5k, 1%; 0805
R13, R14: R-TRIMM3214W; RTRIM3214W
R15: 10k, 1%; 0805
R16: 16.5k, 1%; 0805
R17: 100, 1%; 0805
SJ1, SJ2, SJ3, SJ4, SJ5: SOLDERJUMPERTRACE; SJ_2S-TRACE
U1: PCA9306; VSSOP_8PIN
U2: MCP3008-I/SL; SOIC127P600X175-16N
U3: MCP6064-E/SL; SOIC127P600X175-14N
U$1, U$3, U$4, U$5: SCCDRRV100MDSA3SSCDRRV100MDSA3; DIP1270W53P254L1303H508Q8B
U$2: EMI_SHIELD; 3671250
X1, X2: S4B-XH-A

Connections:
2V: P7.1, R12.1, R15.2
3.3V: D1.7, D1.23, R1.2, R2.2, R10.2, R12.2, R16.2, U1.P2 (VREF1), U2.15 (VREF), U2.16 (VDD), U3.4 (VDD), U$1.VSUPPLY, U$3.VSUPPLY, U$4.VSUPPLY, U$5.VSUPPLY
5V: D1.38, D1.39, R3.2, R4.2, R5.2, X1.2, X2.2
50MILIVOLT: P1.1, R10.1, R11.2
AMP_ADC_1: J3.2, U3.10 (C+)
AMP_ADC_2: J3.3, U3.12 (D+)
CH0: R6.1, U2.1 (CH0), U3.1 (OUTA)
CH1: R7.1, U2.2 (CH1), U3.7 (OUTB)
CH2: R13.3 (E), U2.3 (CH2), U3.8 (OUTC)
CH3: R14.3 (E), U2.4 (CH3), U3.14 (OUTD)
CH6: U2.7 (CH6)
CH7: U2.8 (CH7)
CS_1: D1.8, JP2.15
CS_2: D1.9, JP2.14
CS_3: D1.10, JP2.13
CS_4: D1.11, JP2.12
CS_5: D1.12, JP2.11, SJ1.1
CS_6: D1.13, JP2.10, SJ2.1
CS_7: D1.14, JP2.9, SJ3.1
CS_8: D1.24, JP2.8, SJ4.1
CS_9: D1.25, JP2.7, SJ5.1
CS_10: D1.26, JP2.6
CS_11: D1.27, JP2.5
CS_12: D1.28, JP2.4
CS_13: D1.29, JP2.3
CS_14: D1.30, JP2.2
CS_15: D1.45, JP2.1
GND: C1.2, D1.1, D1.2, D1.3, D1.4, D1.17, D1.18, D1.19, D1.33, D1.34, D1.35, J3.1, R8.1, R9.1, R11.1, R13.1 (A), R14.1 (A), R15.1, R17.1, U1.P1 (GND), U2.9 (DGND), U2.14 (AGND), U3.11 (GND), U$1.GND, U$2.P$1, U$3.GND, U$4.GND, U$5.GND, X1.1, X2.1
MISO: D1.41, U2.12 (DOUT), U$1.MISO, U$3.MISO, U$4.MISO, U$5.MISO
MOSI: D1.42, U2.11 (DIN)
unnamed: R14.2 (S), U3.13 (D-)
unnamed: P6.1, SJ1.2, U2.10 (!CS/SHDN)
unnamed: P2.1, SJ2.2, U$5.SS
unnamed: R13.2 (S), U3.9 (C-)
unnamed: R6.2, R8.2, U3.2 (A-)
unnamed: R7.2, R9.2, U3.6 (B-)
unnamed: P4.1, SJ4.2, U$3.SS
unnamed: P5.1, SJ5.2, U$1.SS
unnamed: J1.2, J1.3, J2.2, J2.3, R16.1, R17.2
unnamed: P3.1, SJ3.2, U$4.SS
OXYGEN1: J1.1, U2.5 (CH4), U3.3 (A+)
OXYGEN2: J2.1, U2.6 (CH5), U3.5 (B+)
RESET: D1.48
SCK: D1.40, U2.13 (CLK), U$1.SCLK, U$3.SCLK, U$4.SCLK, U$5.SCLK
SCL: D1.44, R2.1, U1.P3 (SCL1)
SCL_SV: R4.1, U1.P6 (SCL2), X1.4, X2.4
SDA: D1.43, R1.1, U1.P4 (SDA1)
SDA_5V: R5.1, U1.P5 (SDA2), X1.3, X2.3
USB1_D+: D1.16
USB1_D-: D1.15
USB2_D+: D1.32
USB2_D-: D1.31
USB3_D+: D1.47
USB3_D-: D1.46
VREF2_IN: C1.1, R3.1, U1.P7 (VREF2), U1.P8 (EN)

Notes on the sheet:
Sparkfun Logic Level Translator PCA9306
VCC Range: 1.2 - 5.5V
25mV and 2V source, to calibrate amp gain
Pressure Sensors
Backplane connector ChipSelect header
Flow sensing (With I2C level shifter)
Oxygen sensing
Sensor connectors and 20mV supply added
SPI ADC chip
Op amp with gain resistors
Extra ADC outputs

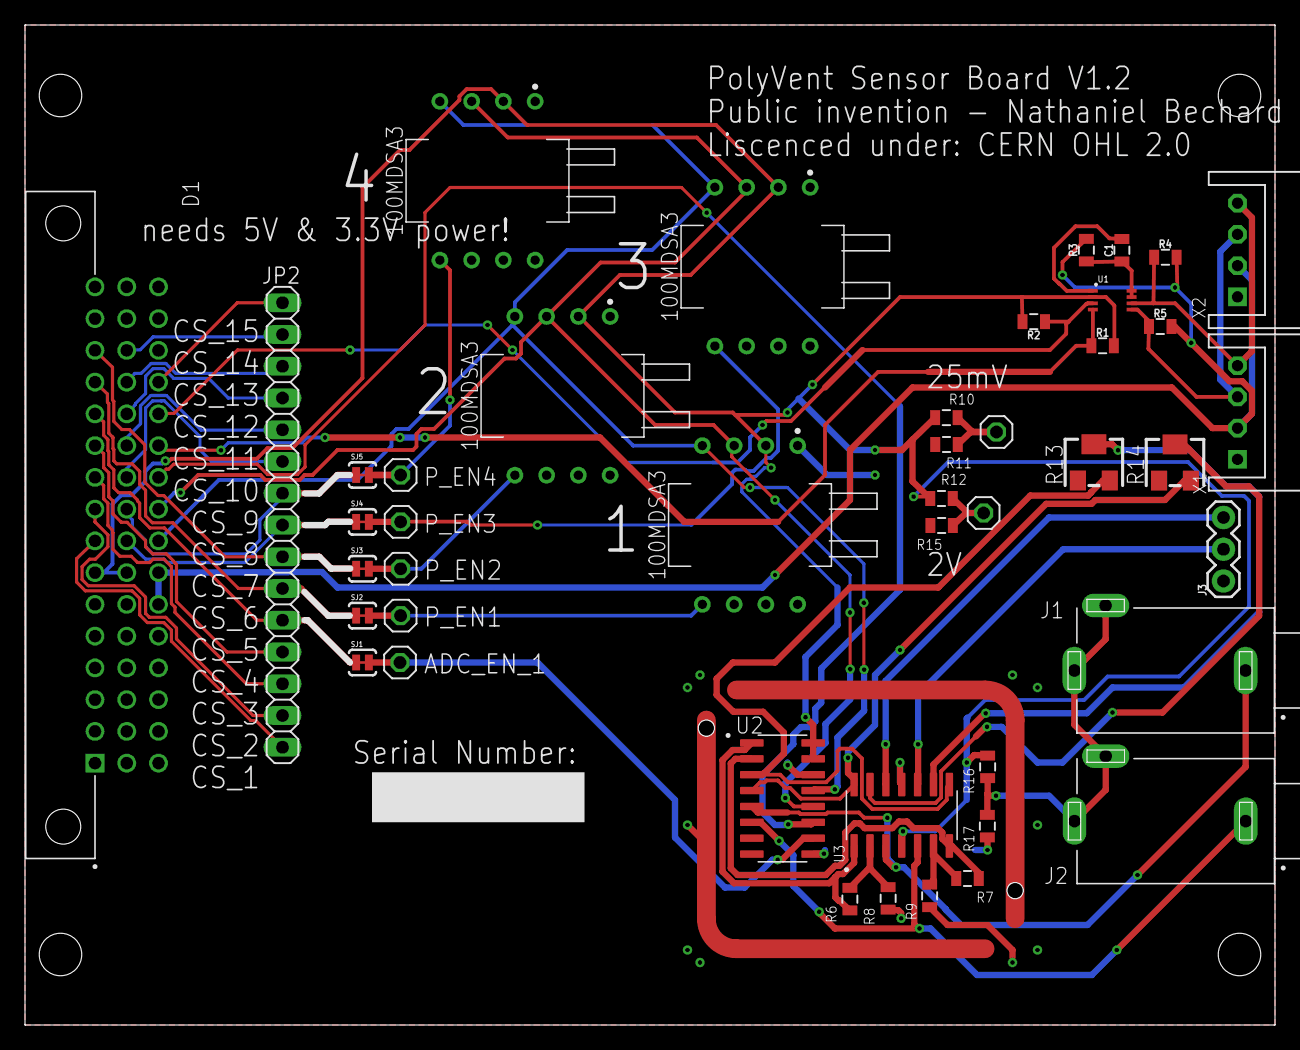
[picture p16: board sensor card.brd from above]

Board: 2 copper layers, 100.0 x 80.0 mm, 45 parts (0 on the bottom side), 46 nets.
