LokiMetaSmith/polyvent_control_module/(commit log)

2021-07-10 Update 3.Prototype/Active/Modular electronics/Designs/Structural_components/.gitkeep
2021-08-05 Deleted 1.Idea/Accepted/.gitkeep, 1.Idea/Active/001_Modular_electronics_more_manufacturable_(V2)/.gitkeep, 1.Idea/Active/001_Modular_electronics_more_manufacturable_(V2)/Idea description, 1.Idea/Acti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
2021-09-05 added the backplane, created a blank card
    [backplane.brd, backplane.sch, blank half eurocard.brd, blank half eurocard.sch]
2021-09-07 routed the wires between backplane connectors, and alligned them with the centers
    [backplane.brd, backplane.sch]
2021-09-07 finished backplane
    [backplane.brd, backplane.sch]
2021-09-08 added libraries and started work on the motor control card
    [backplane.brd, backplane.sch, blank half eurocard.brd, blank half eurocard.sch, motor control board.brd, motor control board.sch]
2021-09-08 finished motor board, will test it on a breadboard now to see if everything makes sense
2021-09-09 motor driver schematic has been verified, added the valves board, will validate it though
    [motor control board.brd, valves card.brd, valves card.sch]
2021-09-09 worked on the perfboard prototype card, validated the valves board mechanism
    [backplane.brd, backplane.sch, prototype card.brd, prototype card.sch]
2021-09-11 general update of most things
    [oxygen sensing.brd, oxygen sensing.sch, prototype card.brd, prototype card.sch, sensor card.brd, sensor card.sch]
2021-09-13 started bom creation
    [copper_bottom.gbr, copper_top.gbr, drill_1_16.xln, gerber_job.gbrjob, profile.gbr, silkscreen_bottom.gbr, silkscreen_top.gbr, soldermask_bottom.gbr]
2021-09-13 fixed library attributes for the din41612 connector, fixed git problems
    [blank half eurocard.brd, blank half eurocard.sch, motor control board.brd, motor control board.sch, prototype card.brd, prototype card.sch, sensor card.brd, sensor card.sch]
2021-09-13 added cam data
    [backplane.brd, backplane.csv, backplane.sch, motor control board.brd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]
2021-09-16 added cam data, and ordered pcb's based on that cam data, will clean up repo next
    [backplane.csv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]
2021-09-25 added libraries
    [valves card.brd, valves card.sch]
2021-10-12 modified backplane
    [backplane.brd, backplane.sch]
2021-10-13 changes saved before switching branch
    [backplane.brd]
2021-10-13 commiting to switch branch
2021-10-13 added labeled backplane breakout connector, backplane pcb is done
    [backplane.brd, backplane.sch]
2021-10-14 fixed stepper driver library
2021-10-14 updated libraries in the boards, traces broke (to be be expected)
    [valves card.brd]
2021-10-14 re routed broken connections from last commit, parts should work now
    [motor control board.brd, motor control board.sch, valves card.sch]
2021-10-14 cleaned up valves board silkscreen, moved header forwards
    [valves card.brd, valves card.sch]
2021-10-14 improved silkscreen for valve board
    [backplane.brd, motor control board.sch, valves card.brd]
2021-10-14 cleaned up sensor board silkscreen + added test pads
    [valves card.brd]
2021-10-14 added folder for new esp32 card
    [esp32_main_card.brd, esp32_main_card.sch]
2021-10-15 changed pinouts for the boards, next I have to make accomodations for new pinouts and the USB selector system
    [blank_card.brd, blank_card.sch, motor control board.brd, prototype card.brd, prototype card.sch, sensor card.brd, sensor card.sch, valves card.brd]
2021-10-15 added a library for the switch I'll be using, and I updated the backplane pinout
    [backplane.brd, backplane.sch]
2021-10-16 made card holes bigger, started usb port work, but I'm not done that part yet
    [blank_card.brd, esp32_main_card.brd, esp32_main_card.sch, motor control board.brd, prototype card.brd, prototype card.sch, valves card.brd, valves card.sch]
2021-10-16 USB system mods complete on the main board, valves board, and motor board
    [motor control board.brd, motor control board.sch, valves card.brd, valves card.sch]
2021-10-16 added on light to main card
    [esp32_main_card.sch, valves card.brd, valves card.sch]
2021-10-16 did some small correction work on the boards
    [backplane.brd, esp32_main_card.brd, motor control board.brd, prototype card.brd, sensor card.brd]
2021-10-16 cleaned up the repo, removed old eagle saves (they're still in the design history, and I removed the old cam data, that has to be redone for the new revisions
    [backplane.csv, sensor card.csv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]
2021-10-16 finished cleanup started review and final mods
    [esp32_main_card.brd, motor control board.csv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]
2021-10-16 final mods to the boards, next commit will add the CAM data, it will be the final commit before the polyvent V2.1 design merge, and I'm ready to order boards
    [backplane.brd, valves card.brd, valves card.sch]
2021-10-21 created backplane V1.2, which can take more power, and has a label to specify wether it is 1oz or 2oz copper
    [copper_bottom.gbr, copper_top.gbr, drill_1_16.xln, gerber_job.gbrjob, profile.gbr, silkscreen_bottom.gbr, silkscreen_top.gbr, soldermask_bottom.gbr]
2021-10-21 added even wider traces to the backplane
    [backplane.brd, backplane.sch]
2021-10-21 added overall schematic of the device
    [schematic.sch]
2021-10-22 added schematics for the overall system
    [backplane.brd, double bellows configuration.sch, proportional configuration #1.sch, schematic.sch]
2021-10-22 got rid of a 0.05mm offset in the position of the din41612 connectors
    [backplane.brd, blank_card.brd, esp32_main_card.brd, motor control board.brd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]
2021-11-01 added pdf versions of the schematics
    [motor control board.sch]
2021-11-19 small mechanical changes to some cards, output connectors were moved around
    [esp32_main_card.brd, esp32_main_card.sch, proportional configuration #1.sch]
2021-11-19 fixed swithc pinout on the main board
    [esp32_main_card.brd, esp32_main_card.sch]
2021-11-20 added sparkfun level shifter to breakout to the sensing board
2021-11-22 update before adc change
    [sensor card.brd]
2021-11-23 added the new oxygen sensing system to the control module
    [sensor card.brd, sensor card.sch]
2021-11-24 updated libraries to generate better bom's
    [backplane.brd, backplane.sch, esp32_main_card.brd, esp32_main_card.sch, motor control board.brd, motor control board.sch, prototype card.brd, prototype card.sch]
2021-11-24 finished V2.2 control module update
    [esp32_main_card.brd, motor control board.sch, prototype card.brd, sensor card.brd, valves card.brd]
2021-11-24 fixed small issue with the sensor emf shield:
    [backplane.brd, sensor card.brd, sensor card.sch]
2021-11-24 small fixes
    [backplane.brd, backplane.sch, esp32_main_card.brd, esp32_main_card.sch, sensor card.brd, sensor card.sch]
2022-01-12 added version 2.2 of the main board, which fixes the I2C pin problem
    [blank_card.brd, esp32_main_card.brd, esp32_main_card.sch, motor control board.brd]
2022-01-12 added case cad's
2022-01-12 added names, and added a blank card faceplate
    [blank_faceplate.f3d, blank_faceplate_v8.step]
2022-01-12 added diode for proportional valve
    [proportional configuration #1.sch]
2022-01-22 merged the firmware from the firmware repo with this one, and changed the folder structure
    [blank_card.brd, blank_card.sch, blank_faceplate.f3d, blank_faceplate_v8.step, double_bellows_configuration.sch, esp32_main_card.brd, esp32_main_card.sch, motor control board.brd]
2022-07-15 fixed the emi cap footprint on the sensing card
    [sensor card.brd, sensor card.sch]
2022-07-15 fixed problems with control module 2.2, all boards are now ready to order
    [prototype card.brd, sensor card.brd]
2022-10-12 master branch ready for RICE university
    [Control module parts list.xlsx, ESP32 card V2.2 v1.f3d, ESP32 card V2.2 v1.step, Education configuration case.f3d, Sensing card V2.2 v1.f3d, Sensing card V2.2 v1.step, Valves card V2.1 v1.f3d, Valves card V2.1 v1.step]
