LokiMetaSmith/polyvent_control_module/(notices)

Notices in the files:
Boards CAD/valves_card/firmware/valves_control_board_code/valves_control_board_code.ino:
This program is free software: you can redistribute it and/or modify
it under the terms of the GNU General Public License as published by
the Free Software Foundation, either version 3 of the License, or
(at your option) any later version.
Boards CAD/sensor_card/board/sensor card.brd:
Liscenced under: CERN OHL 2.0
Boards CAD/prototype_card/board/prototype card.brd:
PolyVent prototyping board V1.2 - Public Invention -Liscence: CERN OHL V2.0
parts and their libraries:
SparkFun-Passives: Licensing: CC v3.0 Share-Alike You are welcome to use this library for commercial purposes.
SparkFun-IC-Comms: Licensing: Creative Commons ShareAlike 4.0 International - https://creativecommons.org/licenses/by-sa/4.0
